indianabutts/picocart/Pinout.ods

Sheet: Sheet1
 | 28 | 27 | 26 | 25 | 24 | 23 | 22 | 21 | 20 | 19 | 18 | 17 | 16 | 15 | 14 | 13 | 12 | 11 | 10 | 9 | 8 | 7 | 6 | 5 | 4 | 3 | 2 | 1 | 0
 | nDOE | nAOE | nWAIT | X | X | X | nWRITE | nSLT | nREAD | X | X | X | X | AD15 | AD14 | AD13 | AD12 | AD11 | AD10 | AD9 | AD8 | AD7 | AD6 | AD5 | AD4 | AD3 | AD2 | AD1 | AD0 | Bin 1 | Bin 2 | Bin 3 | Bin 4 | Full Bin | Hex 1 | Hex 2 | Hex 3 | Hex 4 | Full Hex | C_String
INIT_MASK | 1 | 1 | 1 | 0 | 0 | 0 | 0 | 1 | 1 | 0 | 0 | 0 | 0 | 1 | 1 | 1 | 1 | 1 | 1 | 1 | 1 | 1 | 1 | 1 | 1 | 1 | 1 | 1 | 1 | 00011100 | 00110000 | 11111111 | 11111111 | 00011100001100001111111111111111 | 1C | 30 | FF | FF | 0x1C30FFFF | #define C_GPIO_INIT_MASK 0x1C30FFFF
AD_MASK | 0 | 0 | 0 | 0 | 0 | 0 | 0 | 0 | 0 | 0 | 0 | 0 | 0 | 1 | 1 | 1 | 1 | 1 | 1 | 1 | 1 | 1 | 1 | 1 | 1 | 1 | 1 | 1 | 1 | 00000000 | 00000000 | 11111111 | 11111111 | 00000000000000001111111111111111 | 00 | 00 | FF | FF | 0x0000FFFF | #define C_GPIO_AD_MASK 0x0000FFFF
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
