indianabutts/picocart/boards/footprints/ABM8AIG/ABM8AIG-8.000MHZ-1Z-T--3DModel-STEP-269445.STEP

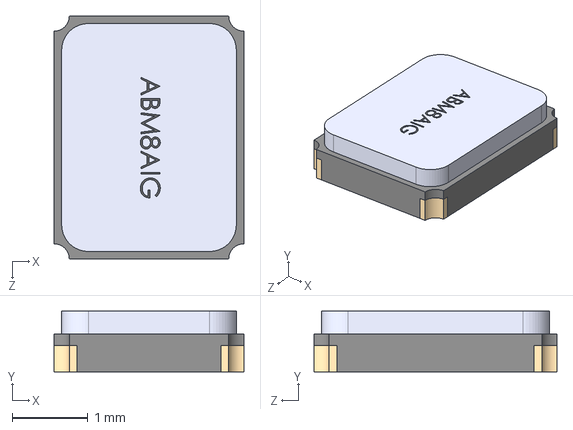
[picture p7: CAD file, 2024-03-03]
boards/footprints/ABM8AIG/ABM8AIG-8.000MHZ-1Z-T--3DModel-STEP-269445.STEP
2.50 x 0.801 x 3.20 mm
