indianabutts/picocart/boards/footprints/DM3AT-SF-PEJM5 Model/DM3AT-SF-PEJM5--3DModel-STEP-1.STEP

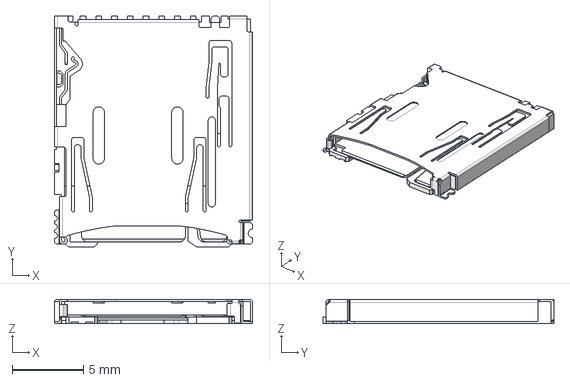
[picture p8: CAD file, 2024-03-03]
boards/footprints/DM3AT-SF-PEJM5 Model/DM3AT-SF-PEJM5--3DModel-STEP-1.STEP
13.8 x 16.2 x 1.68 mm
