indianabutts/picocart/(list of files, cad)

Other CAD files:
boards/full_bus_board/templates/KiCad-RP-Pico-main/SketchUp Model/Pico.skp
