indianabutts/picocart/boards/full_bus_board/rev2b.pdf

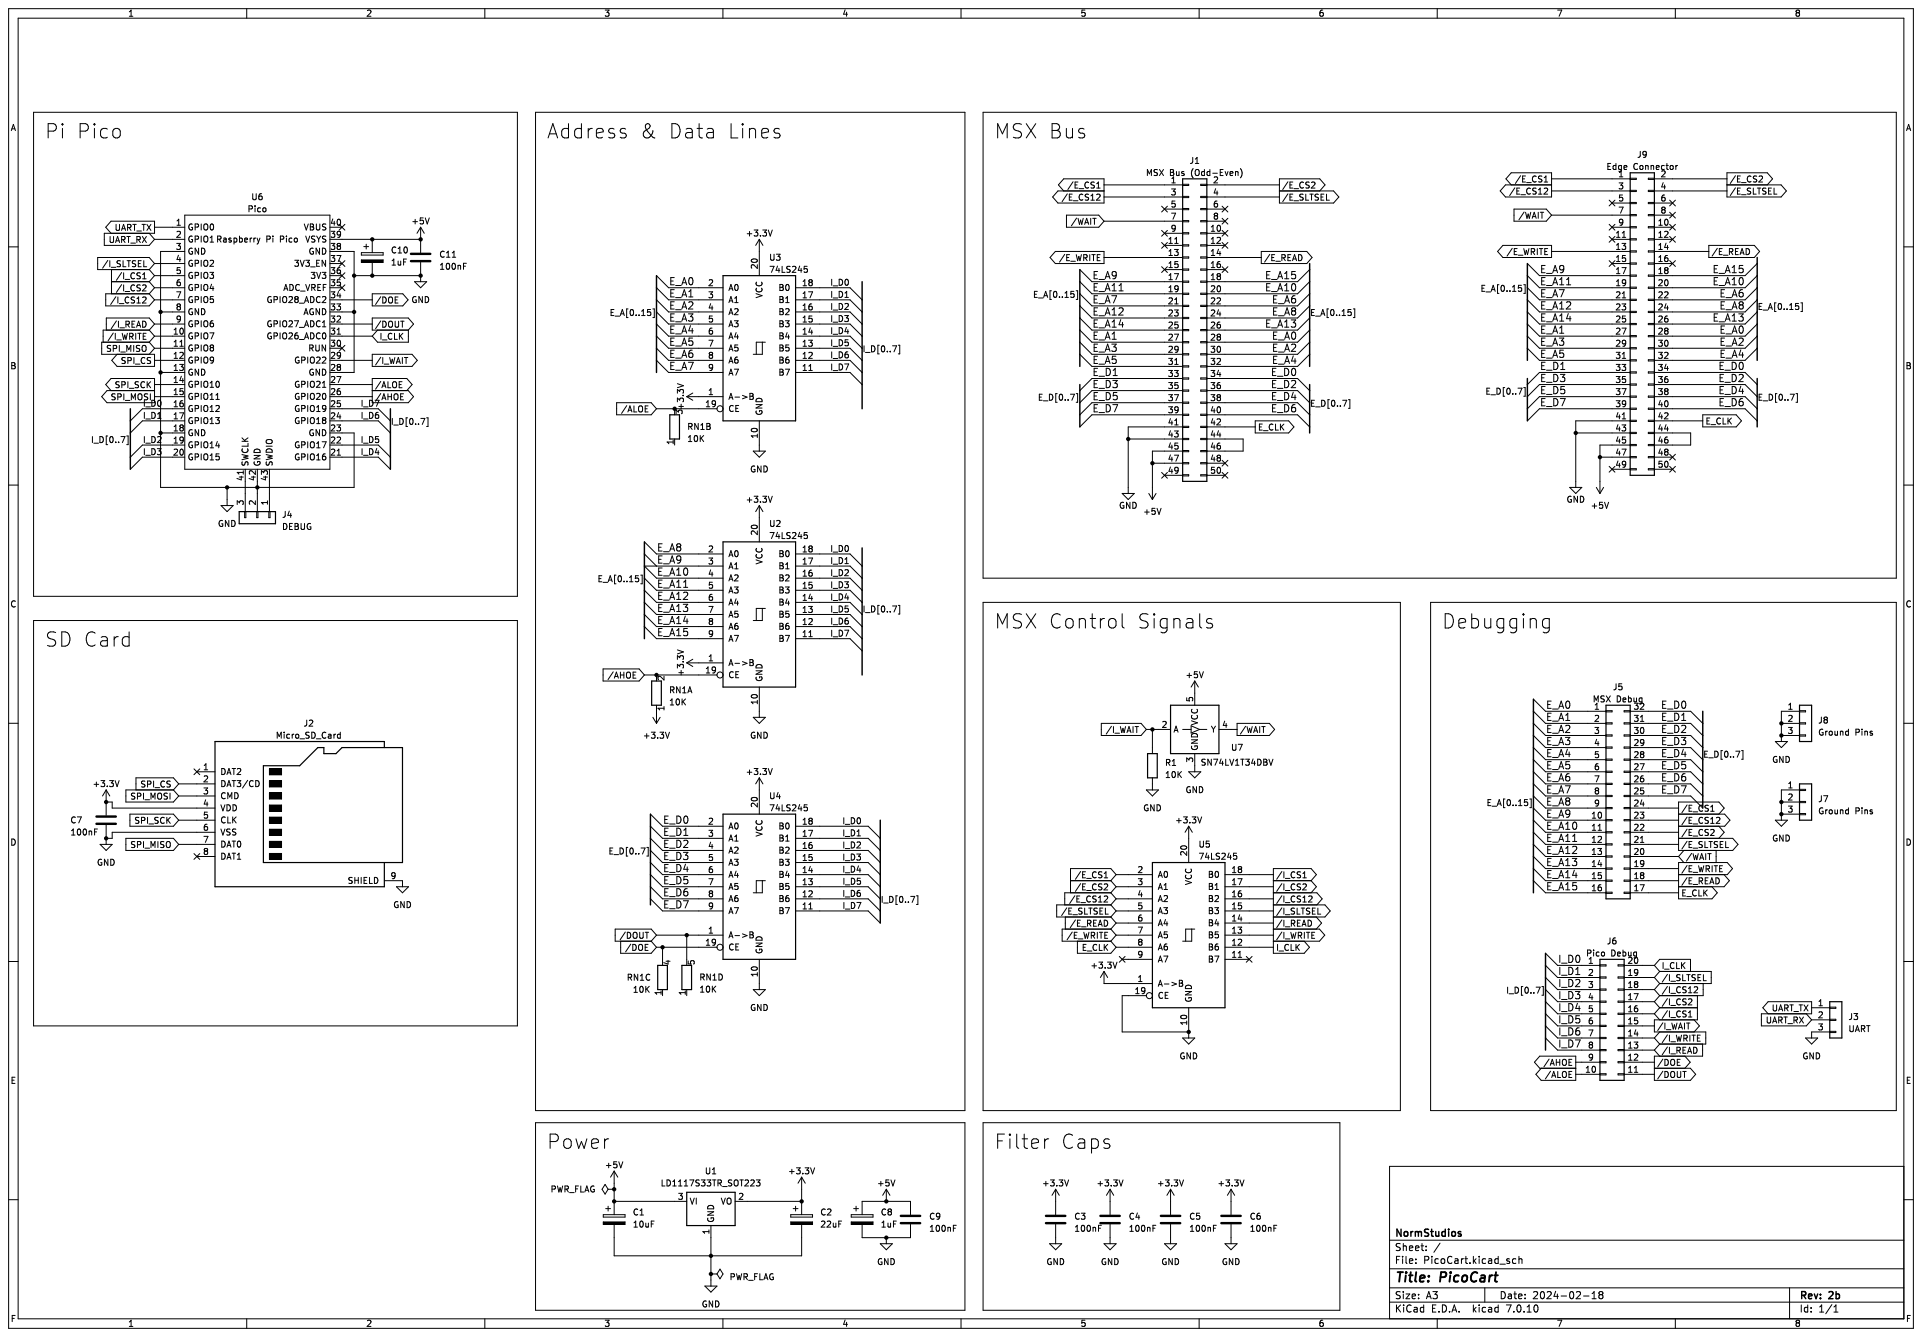
[picture p22: page 1]
