indianabutts/picocart/boards/full_bus_board/PicoCart.kicad_pcb

## KiCad design boards/full_bus_board/PicoCart.kicad_pcb (2024-06-12)

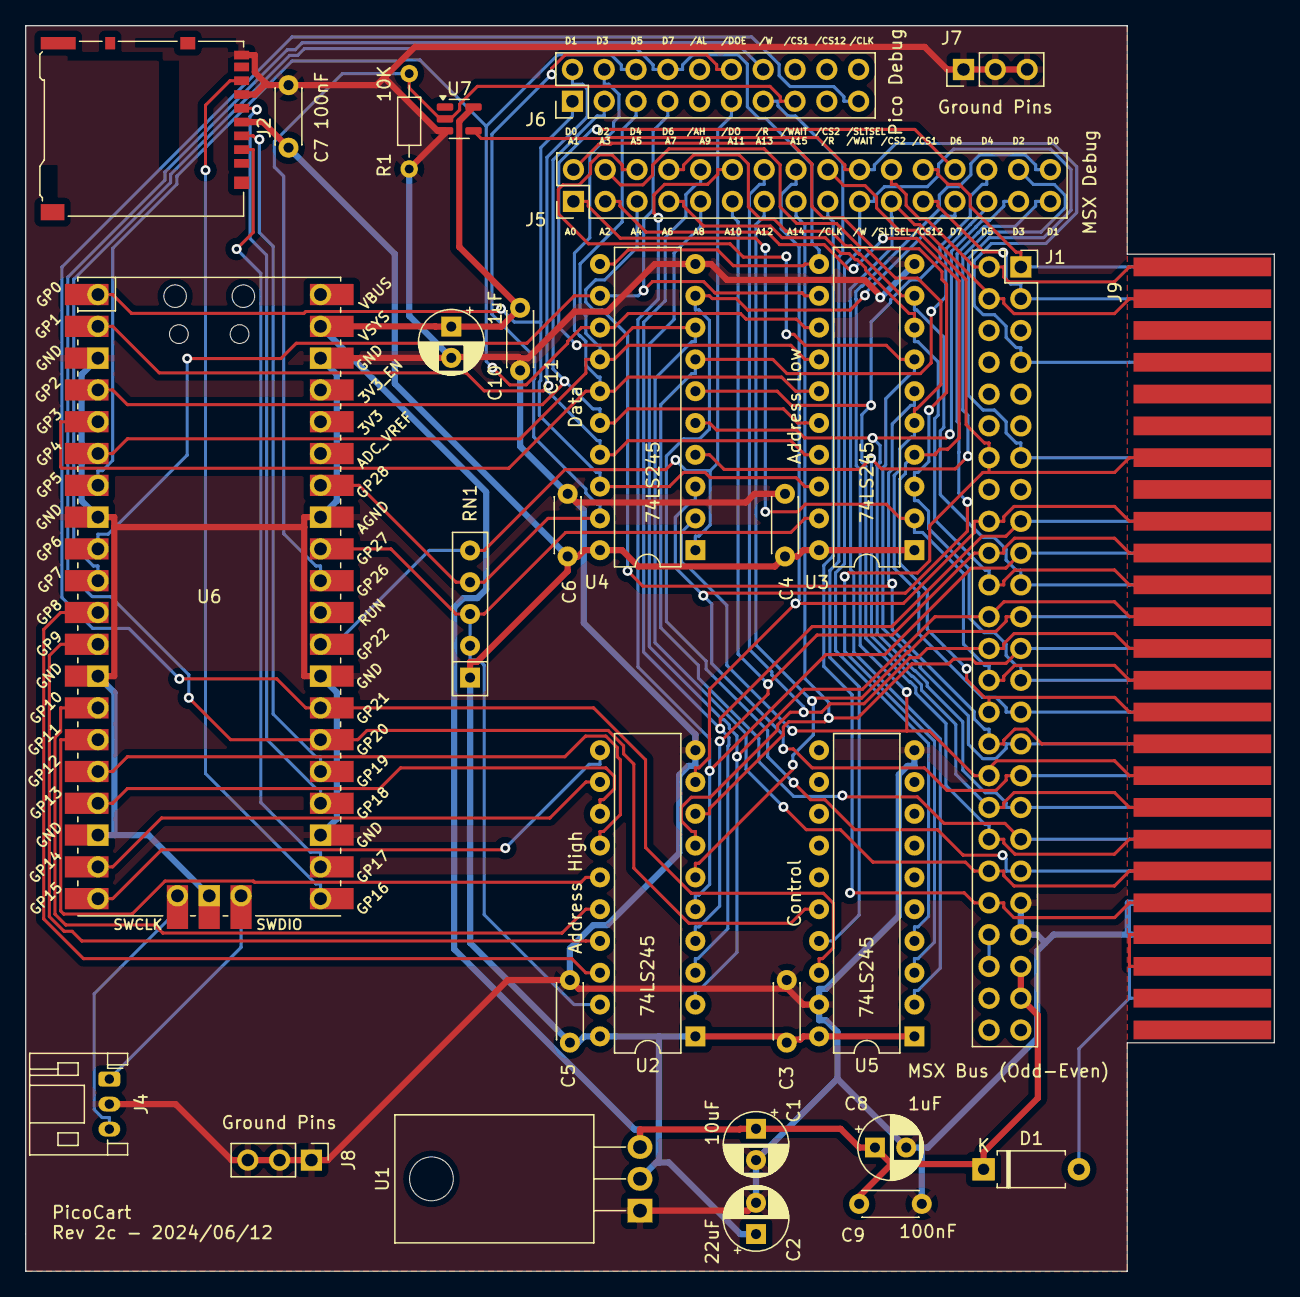
[picture p23: board PicoCart.kicad_pcb from above]

Board: 2 copper layers, 99.8 x 99.5 mm, 29 parts (0 on the bottom side), 67 nets.

Parts:
C1: 10uF; CP_Radial_D5.0mm_P2.50mm
C2: 22uF; CP_Radial_D5.0mm_P2.50mm
C3, C4, C5, C6, C7, C9, C11: 100nF; C_Disc_D4.3mm_W1.9mm_P5.00mm
C8, C10: 1uF; CP_Radial_D5.0mm_P2.50mm
D1: D; D_A-405_P7.62mm_Horizontal
J1: MSX Bus (Odd-Even); PinHeader_2x25_P2.54mm_Vertical
J2: Micro_SD_Card; microSD_HC_Hirose_DM3AT-SF-PEJM5
J4: DEBUG; JST_PH_S3B-PH-K_1x03_P2.00mm_Horizontal
J5: MSX Debug; PinHeader_2x16_P2.54mm_Vertical
J6: Pico Debug; PinHeader_2x10_P2.54mm_Vertical
J7, J8: Ground Pins; PinHeader_1x03_P2.54mm_Vertical
J9: Edge Connector; MSX_Cartridge
R1: 10K; R_Axial_DIN0204_L3.6mm_D1.6mm_P7.62mm_Horizontal
RN1: 10K; R_Array_SIP5
U1: LD1117S33TR_SOT223; TO-220-3_Horizontal_TabDown
U2, U3, U4, U5: 74LS245; DIP-20_W7.62mm
U6: Pico; RPi_Pico_SMD_TH
U7: SN74LV1T34DBV; SOT-23-5

Connections:
+3.3V: C2.1, C3.1, C4.1, C5.1, C6.1, C7.1, J2.4 (VDD), RN1.1 (R1.1), U1.2 (VO), U2.1 (A->B), U2.20 (VCC), U3.1 (A->B), U3.20 (VCC), U4.20 (VCC), U5.1 (A->B), U5.20 (VCC)
+5V: C1.1, C8.1, C9.1, C10.1, C11.1, D1.1 (K), J1.45, J1.47, U1.3 (VI), U6.39 (VSYS), U7.5 (VCC)
/E_A0: J1.28, J5.1, J9.28, U3.2 (A0)
/E_A1: J1.27, J5.2, J9.27, U3.3 (A1)
/E_A2: J1.30, J5.3, J9.30, U3.4 (A2)
/E_A3: J1.29, J5.4, J9.29, U3.5 (A3)
/E_A4: J1.32, J5.5, J9.32, U3.6 (A4)
/E_A5: J1.31, J5.6, J9.31, U3.7 (A5)
/E_A6: J1.22, J5.7, J9.22, U3.8 (A6)
/E_A7: J1.21, J5.8, J9.21, U3.9 (A7)
/E_A8: J1.24, J5.9, J9.24, U2.2 (A0)
/E_A9: J1.17, J5.10, J9.17, U2.3 (A1)
/E_A10: J1.20, J5.11, J9.20, U2.4 (A2)
/E_A11: J1.19, J5.12, J9.19, U2.5 (A3)
/E_A12: J1.23, J5.13, J9.23, U2.6 (A4)
/E_A13: J1.26, J5.14, J9.26, U2.7 (A5)
/E_A14: J1.25, J5.15, J9.25, U2.8 (A6)
/E_A15: J1.18, J5.16, J9.18, U2.9 (A7)
/E_D0: J1.34, J5.32, J9.34, U4.2 (A0)
/E_D1: J1.33, J5.31, J9.33, U4.3 (A1)
/E_D2: J1.36, J5.30, J9.36, U4.4 (A2)
/E_D3: J1.35, J5.29, J9.35, U4.5 (A3)
/E_D4: J1.38, J5.28, J9.38, U4.6 (A4)
/E_D5: J1.37, J5.27, J9.37, U4.7 (A5)
/E_D6: J1.40, J5.26, J9.40, U4.8 (A6)
/E_D7: J1.39, J5.25, J9.39, U4.9 (A7)
/I_D0: J6.1, U3.18 (B0), U4.18 (B0), U6.1 (GPIO0)
/I_D1: J6.2, U3.17 (B1), U4.17 (B1), U6.2 (GPIO1)
/I_D2: J6.3, U3.16 (B2), U4.16 (B2), U6.4 (GPIO2)
/I_D3: J6.4, U3.15 (B3), U4.15 (B3), U6.5 (GPIO3)
/I_D4: J6.5, U3.14 (B4), U4.14 (B4), U6.6 (GPIO4)
/I_D5: J6.6, U3.13 (B5), U4.13 (B5), U6.7 (GPIO5)
/I_D6: J6.7, U3.12 (B6), U4.12 (B6), U6.9 (GPIO6)
/I_D7: J6.8, U3.11 (B7), U4.11 (B7), U6.10 (GPIO7)
/I_D8: U2.18 (B0), U6.11 (GPIO8)
/I_D9: U2.17 (B1), U6.12 (GPIO9)
/I_D10: U2.16 (B2), U6.14 (GPIO10)
/I_D11: U2.15 (B3), U6.15 (GPIO11)
/I_D12: U2.14 (B4), U6.16 (GPIO12)
/I_D13: U2.13 (B5), U6.17 (GPIO13)
/I_D14: U2.12 (B6), U6.19 (GPIO14)
/I_D15: U2.11 (B7), U6.20 (GPIO15)
E_CLK: J1.42, J5.17, J9.42
GND: C1.2, C2.2, C3.2, C4.2, C5.2, C6.2, C7.2, C8.2, C9.2, C10.2, C11.2, J1.41, J1.43, J2.6 (VSS), J2.9 (SHIELD), J4.2, J7.1, J7.2, J7.3, J8.1, J8.2, J8.3, J9.41, J9.43, R1.1, U1.1 (GND), U2.10 (GND), U3.10 (GND), U4.10 (GND), U5.10 (GND), U5.19 (CE), U6.3 (GND), U6.8 (GND), U6.13 (GND), U6.18 (GND), U6.23 (GND), U6.28 (GND), U6.33 (AGND), U6.38 (GND), U6.42 (GND), U7.3 (GND)
unnamed: D1.2 (A), J9.45, J9.47
unnamed: J1.44, J1.46
unnamed: J4.1, U6.43 (SWDIO)
unnamed: J4.3, U6.41 (SWCLK)
unnamed: J9.44, J9.46
SPI_CS: J2.2 (DAT3/CD), U6.22 (GPIO17)
SPI_MISO: J2.7 (DAT0), U6.21 (GPIO16)
SPI_MOSI: J2.3 (CMD), U6.25 (GPIO19)
SPI_SCK: J2.5 (CLK), U6.24 (GPIO18)
/AOE: RN1.2 (R1.2), RN1.3 (R2.2), U2.19 (CE), U3.19 (CE), U6.32 (GPIO27_ADC1)
/DOE: J6.12, RN1.4 (R3.2), U4.19 (CE), U6.34 (GPIO28_ADC2)
/DOUT: J6.11, RN1.5 (R4.2), U4.1 (A->B), U6.29 (GPIO22)
/E_CS1: J1.1, J5.24, J9.1
/E_CS2: J1.2, J5.22, J9.2
/E_CS12: J1.3, J5.23, J9.3
/E_READ: J1.14, J5.18, J9.14, U5.3 (A1)
/E_SLTSEL: J1.4, J5.21, J9.4, U5.2 (A0)
/E_WRITE: J1.13, J5.19, J9.13, U5.4 (A2)
/I_READ: J6.13, U5.17 (B1)
/I_SLTSEL: J6.19, U5.18 (B0), U6.27 (GPIO21)
/I_WAIT: J6.15, R1.2, U6.31 (GPIO26_ADC0), U7.2 (A)
/I_WRITE: J6.14, U5.16 (B2), U6.26 (GPIO20)
/WAIT: J1.7, J5.20, J9.7, U7.4 (Y)
