indianabutts/picocart/boards/debug_board/PicoCart_DEBUG.kicad_pcb

## KiCad design boards/debug_board/PicoCart_DEBUG.kicad_pcb (2024-03-08)

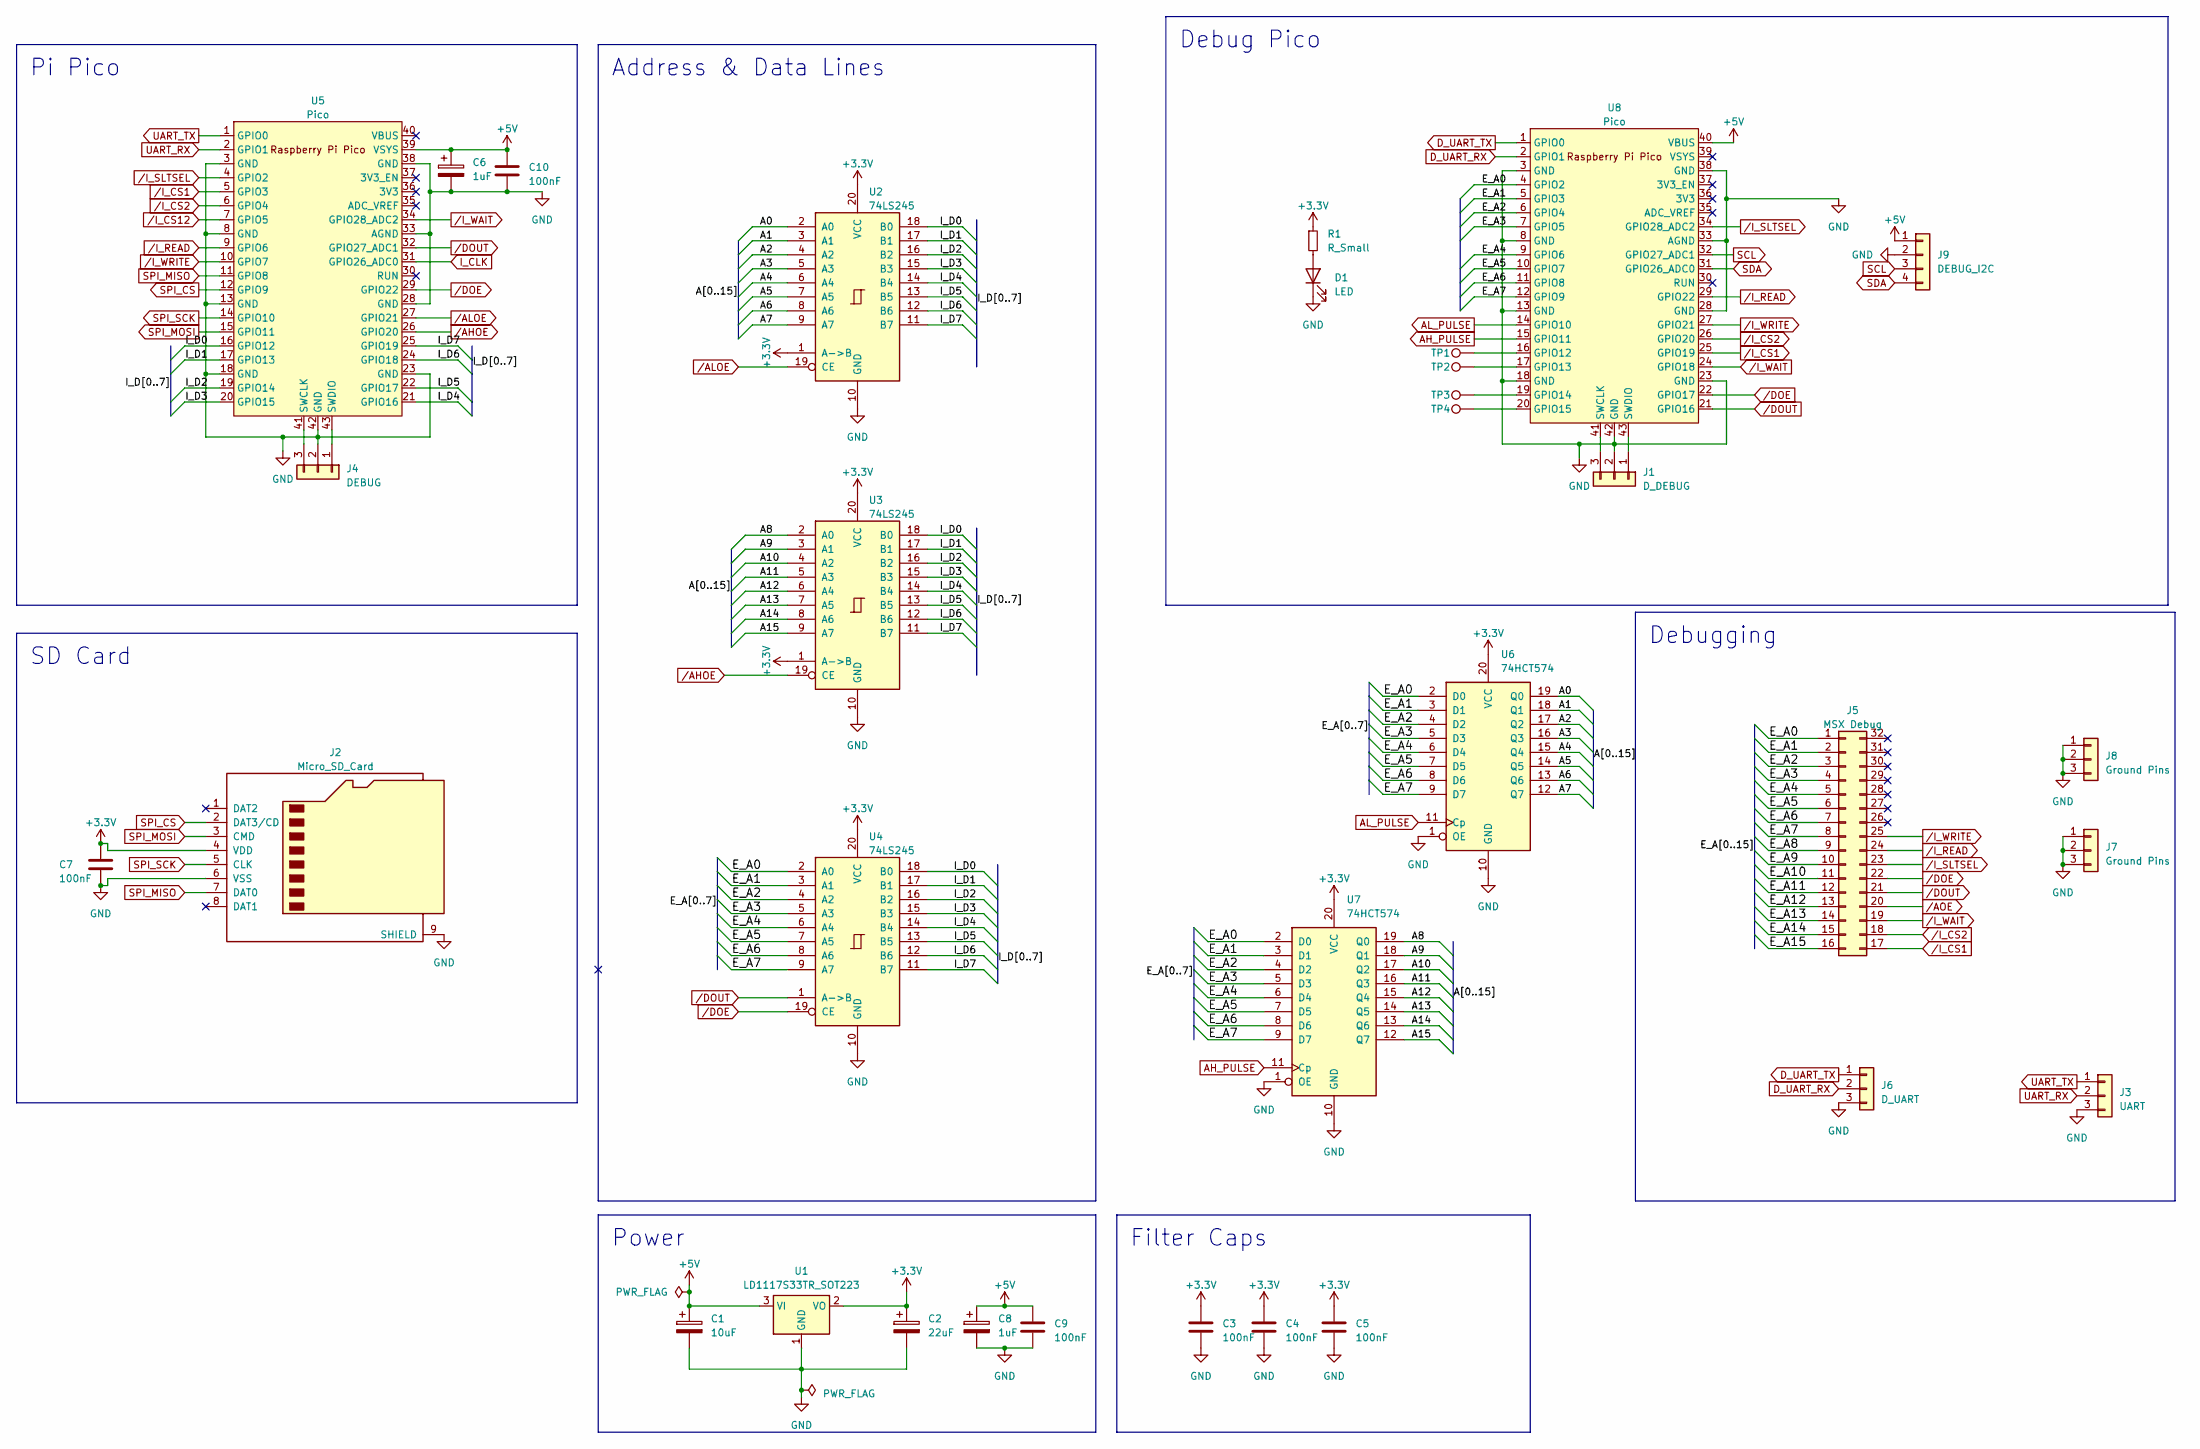
[picture p24: schematic PicoCart_DEBUG.kicad_sch, PicoCart]

Parts:
C1: 10uF; CP_Radial_D5.0mm_P2.50mm
C2: 22uF; CP_Radial_D5.0mm_P2.50mm
C3, C4, C5, C7, C9, C10: 100nF; C_Disc_D4.3mm_W1.9mm_P5.00mm
C6, C8: 1uF; CP_Radial_D5.0mm_P2.50mm
D1: LED; LED_D5.0mm
J1: D_DEBUG; PinSocket_1x03_P2.54mm_Vertical
J2: Micro_SD_Card; microSD_HC_Hirose_DM3AT-SF-PEJM5
J3: UART; PinSocket_1x03_P2.54mm_Vertical
J4: DEBUG; PinSocket_1x03_P2.54mm_Vertical
J5: MSX Debug; PinHeader_2x16_P2.54mm_Vertical
J6: D_UART; PinSocket_1x03_P2.54mm_Vertical
J7, J8: Ground Pins; PinHeader_1x03_P2.54mm_Vertical
J9: DEBUG_I2C; PinHeader_1x04_P2.54mm_Vertical
R1: R_Small; R_Axial_DIN0207_L6.3mm_D2.5mm_P15.24mm_Horizontal
TP1, TP2, TP3, TP4: TestPoint; TestPoint_Pad_D1.0mm
U1: LD1117S33TR_SOT223; TO-220-3_Horizontal_TabDown
U2, U3, U4: 74LS245; DIP-20_W7.62mm
U5, U8: Pico; RPi_Pico_SMD_TH
U6, U7: 74HCT574; DIP-20_W7.62mm_Socket_LongPads

Connections:
+3.3V: C2.1, C3.1, C4.1, C5.1, C7.1, J2.4 (VDD), R1.1, U1.2 (VO), U2.1 (A->B), U2.20 (VCC), U3.1 (A->B), U3.20 (VCC), U4.20 (VCC), U6.20 (VCC), U7.20 (VCC)
+5V: C1.1, C6.1, C8.1, C9.1, C10.1, J9.1, U1.3 (VI), U5.39 (VSYS), U8.40 (VBUS)
/A0: U2.2 (A0), U6.19 (Q0)
/A1: U2.3 (A1), U6.18 (Q1)
/A2: U2.4 (A2), U6.17 (Q2)
/A3: U2.5 (A3), U6.16 (Q3)
/A4: U2.6 (A4), U6.15 (Q4)
/A5: U2.7 (A5), U6.14 (Q5)
/A6: U2.8 (A6), U6.13 (Q6)
/A7: U2.9 (A7), U6.12 (Q7)
/A8: U3.2 (A0), U7.19 (Q0)
/A9: U3.3 (A1), U7.18 (Q1)
/A10: U3.4 (A2), U7.17 (Q2)
/A11: U3.5 (A3), U7.16 (Q3)
/A12: U3.6 (A4), U7.15 (Q4)
/A13: U3.7 (A5), U7.14 (Q5)
/A14: U3.8 (A6), U7.13 (Q6)
/A15: U3.9 (A7), U7.12 (Q7)
/E_A0: J5.1, U4.2 (A0), U6.2 (D0), U7.2 (D0), U8.4 (GPIO2)
/E_A1: J5.2, U4.3 (A1), U6.3 (D1), U7.3 (D1), U8.5 (GPIO3)
/E_A2: J5.3, U4.4 (A2), U6.4 (D2), U7.4 (D2), U8.6 (GPIO4)
/E_A3: J5.4, U4.5 (A3), U6.5 (D3), U7.5 (D3), U8.7 (GPIO5)
/E_A4: J5.5, U4.6 (A4), U6.6 (D4), U7.6 (D4), U8.9 (GPIO6)
/E_A5: J5.6, U4.7 (A5), U6.7 (D5), U7.7 (D5), U8.10 (GPIO7)
/E_A6: J5.7, U4.8 (A6), U6.8 (D6), U7.8 (D6), U8.11 (GPIO8)
/E_A7: J5.8, U4.9 (A7), U6.9 (D7), U7.9 (D7), U8.12 (GPIO9)
/E_A8: J5.9
/E_A9: J5.10
/E_A10: J5.11
/E_A11: J5.12
/E_A12: J5.13
/E_A13: J5.14
/E_A14: J5.15
/E_A15: J5.16
/I_D0: U2.18 (B0), U3.18 (B0), U4.18 (B0), U5.16 (GPIO12)
/I_D1: U2.17 (B1), U3.17 (B1), U4.17 (B1), U5.17 (GPIO13)
/I_D2: U2.16 (B2), U3.16 (B2), U4.16 (B2), U5.19 (GPIO14)
/I_D3: U2.15 (B3), U3.15 (B3), U4.15 (B3), U5.20 (GPIO15)
/I_D4: U2.14 (B4), U3.14 (B4), U4.14 (B4), U5.21 (GPIO16)
/I_D5: U2.13 (B5), U3.13 (B5), U4.13 (B5), U5.22 (GPIO17)
/I_D6: U2.12 (B6), U3.12 (B6), U4.12 (B6), U5.24 (GPIO18)
/I_D7: U2.11 (B7), U3.11 (B7), U4.11 (B7), U5.25 (GPIO19)
AH_PULSE: U7.11 (Cp), U8.15 (GPIO11)
AL_PULSE: U6.11 (Cp), U8.14 (GPIO10)
D_UART_RX: J6.2, U8.2 (GPIO1)
D_UART_TX: J6.1, U8.1 (GPIO0)
GND: C1.2, C2.2, C3.2, C4.2, C5.2, C6.2, C7.2, C8.2, C9.2, C10.2, D1.1 (K), J1.2, J2.6 (VSS), J2.9 (SHIELD), J3.3, J4.2, J6.3, J7.1, J7.2, J7.3, J8.1, J8.2, J8.3, J9.2, U1.1 (GND), U2.10 (GND), U3.10 (GND), U4.10 (GND), U5.3 (GND), U5.8 (GND), U5.13 (GND), U5.18 (GND), U5.23 (GND), U5.28 (GND), U5.33 (AGND), U5.38 (GND), U5.42 (GND), U6.1 (OE), U6.10 (GND), U7.1 (OE), U7.10 (GND), U8.3 (GND), U8.8 (GND), U8.13 (GND), U8.18 (GND), U8.23 (GND), U8.28 (GND), U8.33 (AGND), U8.38 (GND), U8.42 (GND)
I_CLK: U5.31 (GPIO26_ADC0)
unnamed: D1.2 (A), R1.2
unnamed: J1.1, U8.43 (SWDIO)
unnamed: J1.3, U8.41 (SWCLK)
unnamed: J4.1, U5.43 (SWDIO)
unnamed: J4.3, U5.41 (SWCLK)
unnamed: TP1.1, U8.16 (GPIO12)
unnamed: TP2.1, U8.17 (GPIO13)
unnamed: TP3.1, U8.19 (GPIO14)
unnamed: TP4.1, U8.20 (GPIO15)
SCL: J9.3, U8.32 (GPIO27_ADC1)
SDA: J9.4, U8.31 (GPIO26_ADC0)
SPI_CS: J2.2 (DAT3/CD), U5.12 (GPIO9)
SPI_MISO: J2.7 (DAT0), U5.11 (GPIO8)
SPI_MOSI: J2.3 (CMD), U5.15 (GPIO11)
SPI_SCK: J2.5 (CLK), U5.14 (GPIO10)
UART_RX: J3.2, U5.2 (GPIO1)
UART_TX: J3.1, U5.1 (GPIO0)
/AHOE: U3.19 (CE), U5.26 (GPIO20)
/ALOE: U2.19 (CE), U5.27 (GPIO21)
/AOE: J5.20
/DOE: J5.22, U4.19 (CE), U5.29 (GPIO22), U8.22 (GPIO17)
/DOUT: J5.21, U4.1 (A->B), U5.32 (GPIO27_ADC1), U8.21 (GPIO16)
/I_CS1: J5.17, U5.5 (GPIO3), U8.25 (GPIO19)
/I_CS2: J5.18, U5.6 (GPIO4), U8.26 (GPIO20)
/I_CS12: U5.7 (GPIO5)
/I_READ: J5.24, U5.9 (GPIO6), U8.29 (GPIO22)
/I_SLTSEL: J5.23, U5.4 (GPIO2), U8.34 (GPIO28_ADC2)
/I_WAIT: J5.19, U5.34 (GPIO28_ADC2), U8.24 (GPIO18)
/I_WRITE: J5.25, U5.10 (GPIO7), U8.27 (GPIO21)

Notes on the sheet:
Pi Pico
Debug Pico
Debugging
Filter Caps
Power
SD Card
Address & Data Lines

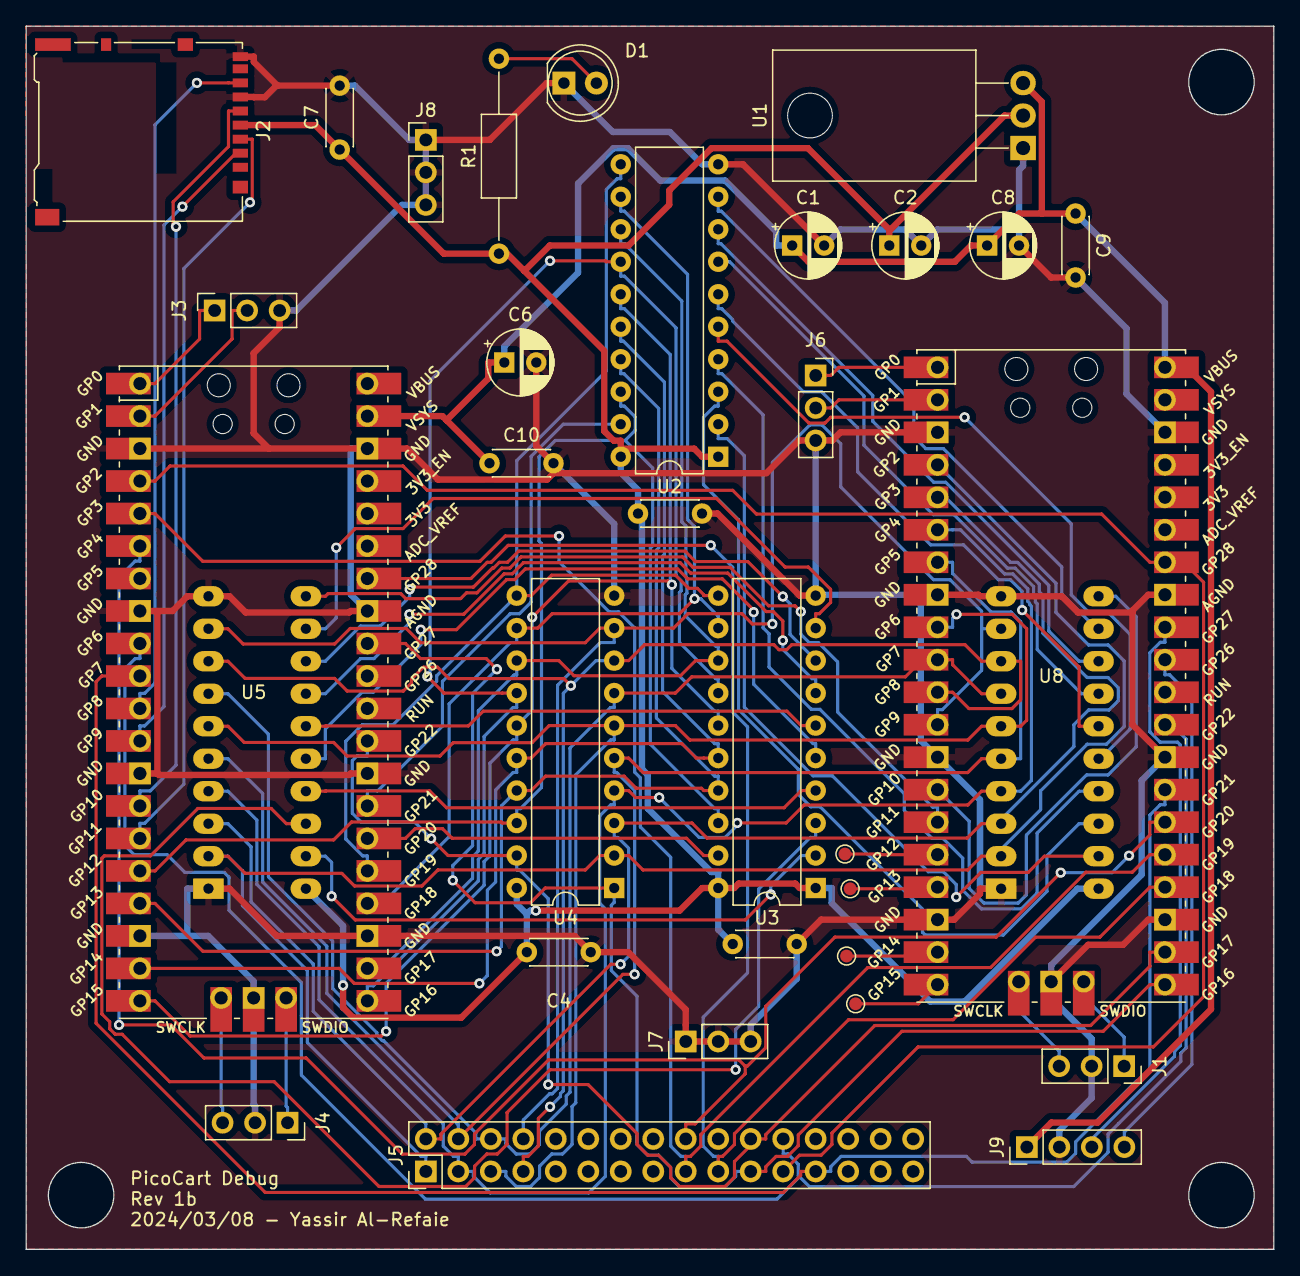
[picture p25: board PicoCart_DEBUG.kicad_pcb from above]

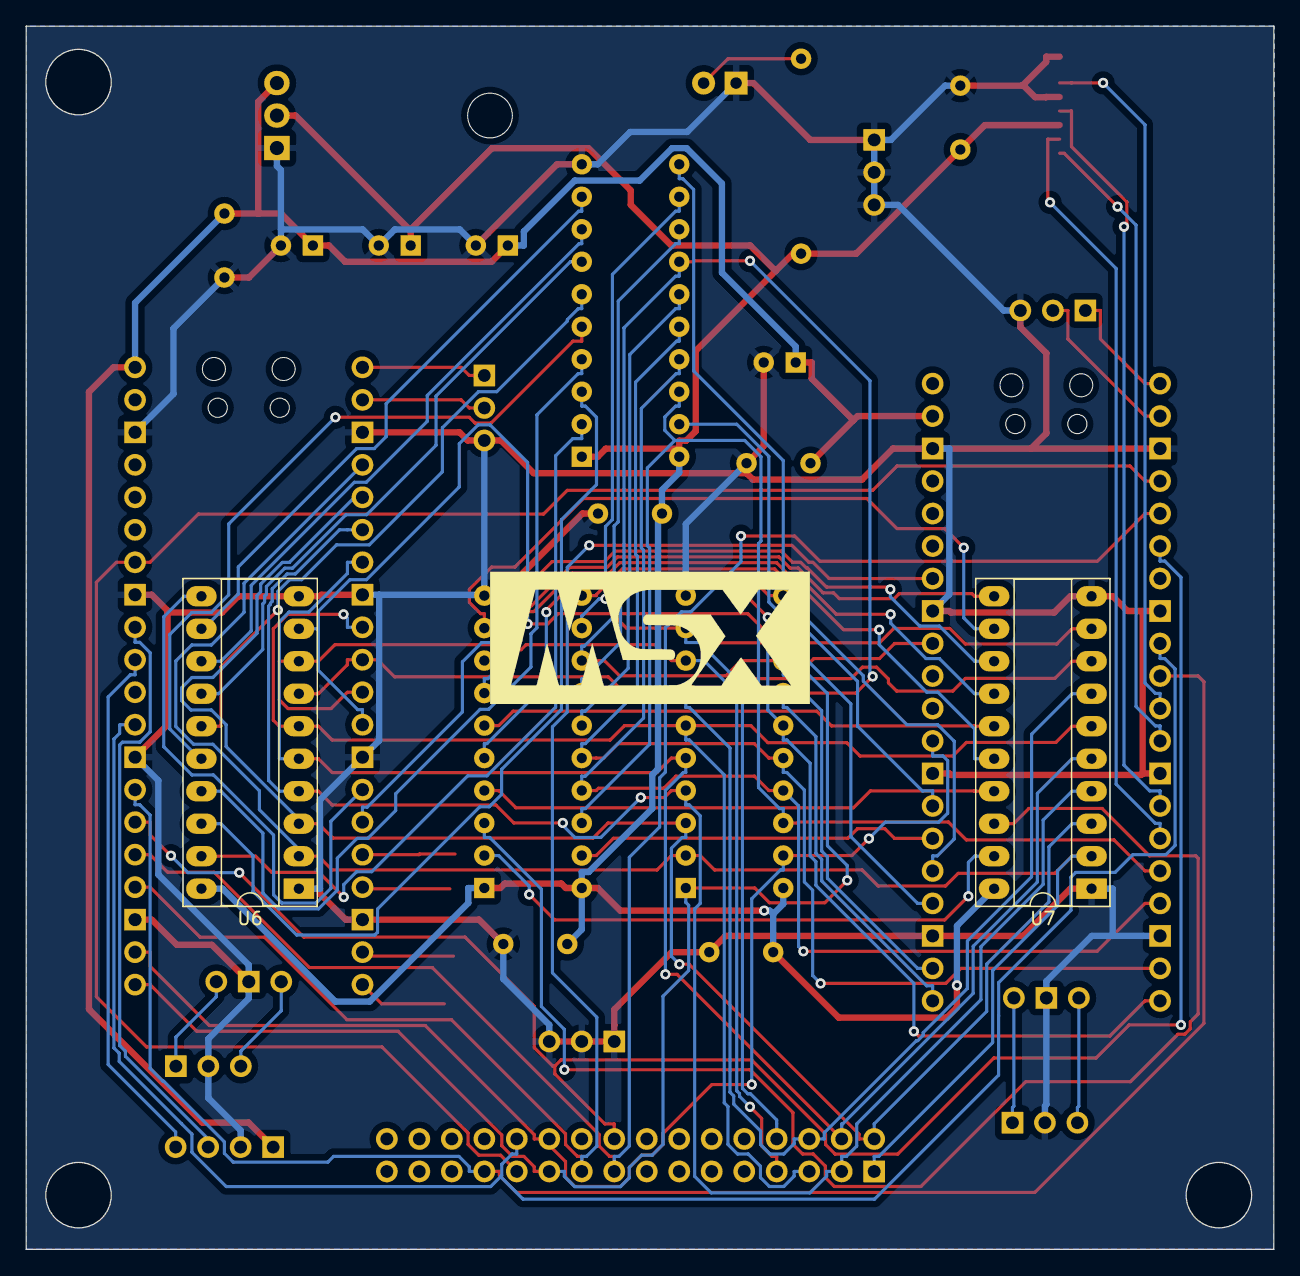
[picture p26: board PicoCart_DEBUG.kicad_pcb from below]

Board: 2 copper layers, 97.5 x 95.6 mm, 33 parts (2 on the bottom side), 66 nets.
