indianabutts/picocart/rp2040_src/core_board/shared_includes/data.h

#ifndef DEBUG_MSX_DATA_H
#define DEBUG_MSX_DATA_H

// array size is 8192
static const unsigned char debug_data[]  = {
  0x41, 0x42, 0x20, 0x40, 0x00, 0x00, 0x00, 0x00, 0x00, 0x00, 0x00, 0x00, 0x00, 0x00, 0x00, 0x00, 
  0x06, 0x20, 0x54, 0x61, 0x6e, 0x6b, 0x20, 0x42, 0x61, 0x74, 0x61, 0x6c, 0x69, 0x6f, 0x6e, 0x20, 
  0x31, 0x00, 0xff, 0x21, 0x00, 0xe0, 0x36, 0x00, 0x23, 0x7c, 0xfe, 0xee, 0x20, 0xf8, 0x21, 0xfc, 
  0x40, 0x01, 0x00, 0x08, 0xc5, 0x46, 0xcd, 0x47, 0x00, 0xc1, 0x23, 0x0c, 0x10, 0xf6, 0xcd, 0xc4, 
  0x40, 0xcd, 0x4f, 0x52, 0x11, 0x40, 0xe8, 0x01, 0x10, 0x41, 0xcd, 0xcf, 0x40, 0x11, 0x80, 0xe8, 
  0x01, 0xa6, 0x58, 0xcd, 0xcf, 0x40, 0x3e, 0x07, 0x1e, 0xb8, 0xcd, 0x93, 0x00, 0x3e, 0xc3, 0x32, 
  0x9a, 0xfd, 0x21, 0x70, 0x40, 0x22, 0x9b, 0xfd, 0x01, 0x01, 0xe2, 0xcd, 0x47, 0x00, 0x18, 0xfe, 
  0x31, 0x00, 0xff, 0xcd, 0x3e, 0x01, 0x01, 0x01, 0xc2, 0xcd, 0x47, 0x00, 0x11, 0x80, 0xe8, 0xcd, 
  0xde, 0x40, 0xcd, 0x44, 0x56, 0x3a, 0x10, 0xe0, 0x0f, 0x30, 0x0b, 0x3a, 0x97, 0xe0, 0xa7, 0x28, 
  0xd7, 0xcd, 0x52, 0x43, 0x18, 0xd2, 0x21, 0x00, 0xef, 0x11, 0x00, 0x2f, 0x01, 0xa0, 0x00, 0xcd, 
  0x5c, 0x00, 0xcd, 0xc4, 0x40, 0x21, 0x48, 0xe0, 0x36, 0x20, 0x3a, 0x16, 0xe0, 0x0f, 0x38, 0x05, 
  0x21, 0x7c, 0xef, 0x18, 0x03, 0x21, 0x00, 0xef, 0x22, 0x49, 0xe0, 0x11, 0x40, 0xe8, 0xcd, 0xde, 
  0x40, 0xc3, 0x68, 0x40, 0x01, 0xe0, 0x80, 0x21, 0x00, 0xef, 0x71, 0x23, 0x10, 0xfc, 0xc9, 0x21, 
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
  0xe0, 0x35, 0x3a, 0x61, 0xe0, 0xd6, 0x01, 0x27, 0x32, 0x61, 0xe0, 0xcd, 0x17, 0x58, 0xc3, 0x10, 
  0x43, 0x3a, 0x19, 0xe0, 0xa7, 0xca, 0xf8, 0x42, 0x3a, 0x61, 0xe0, 0xd6, 0x01, 0x27, 0x32, 0x61, 
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
};

#endif
