indianabutts/picocart/rp2040_src/core_board/shared_includes/sd_hw.c

#include <assert.h>
#include <string.h>
#include "hw_config.h"
#include "diskio.h" /* Declarations of disk functions */

// SPI Defines
// We are going to use SPI 0, and allocate it to the following GPIO pins
// Pins can be changed, see the GPIO function select table in the datasheet for information on GPIO assignments
#define SPI_PORT spi1
#define PIN_MISO 16
#define PIN_CS   17
#define PIN_SCK  18
#define PIN_MOSI 19

static spi_t spis[] = {
    {
	.hw_inst = spi1,
	.miso_gpio = PIN_MISO,
	.mosi_gpio = PIN_MOSI,
	.sck_gpio = PIN_SCK,
	.baud_rate = 12500 * 1000
    }
};

static sd_card_t sd_cards[] = {
    {
	.pcName = "0:",
	.spi = &spis[0],
	.ss_gpio = PIN_CS,
	.use_card_detect = false
    }
};

size_t sd_get_num() { return count_of(sd_cards);}

sd_card_t *sd_get_by_num(size_t num) {
    assert(num <= sd_get_num());
    if (num <= sd_get_num()){
	return &sd_cards[num];
    } else {
	return NULL;
    }
}

size_t spi_get_num() { return count_of(spis); }
spi_t *spi_get_by_num(size_t num) {
    assert(num <= spi_get_num());
    if (num <= spi_get_num()) {
        return &spis[num];
    } else {
        return NULL;
    }
}
