indianabutts/picocart/(commit log)

2023-10-09 Add SD library for Pi Pico
2024-02-17 brought board and rp2040 src together
    [Pico.skp, PicoCart.kicad_pcb, PicoCart.kicad_sch, Test.kicad_pcb, Test.kicad_sch]
2024-02-18 Tidied up Schematic
    [PicoCart.kicad_sch]
2024-02-18 Swapped DoE and IWait
    [PicoCart.kicad_sch]
2024-03-03 Debug Board Design
    Created a Debug board so that I can test the Main Pico logic against a
    more controllable set of signals, rather than the MSX which provides a
    very short window of usability
    [ABM8AIG-8.000MHZ-1Z-T--3DModel-STEP-269445.STEP, DM3AT-SF-PEJM5--3DModel-STEP-1.STEP, PicoCart.kicad_pcb, PicoCart.kicad_sch]
2024-03-03 Separate Debug and Main Board Projects
    [ABM8AIG-8.000MHZ-1Z-T--3DModel-STEP-269445.STEP, DM3AT-SF-PEJM5--3DModel-STEP-1.STEP, Pico.skp, PicoCart.kicad_pcb, PicoCart.kicad_sch, PicoCart_DEBUG.kicad_pcb, PicoCart_DEBUG.kicad_sch, Test.kicad_pcb]
2024-03-08 Fixed circuit - last design would not have worked
    [PicoCart_DEBUG.kicad_pcb, PicoCart_DEBUG.kicad_sch]
2024-03-08 Add Test Points for Spare GPIO Pins
    [PicoCart_DEBUG.kicad_pcb, PicoCart_DEBUG.kicad_sch]
2024-03-23 Add Debug Board Src dir
2024-03-24 Initial Printing to LCD Display
2024-03-26 Display Works and Debug board triggers main board
    Not full functionality by any means, but the debug board now pulses
    nSLTSEL, which triggers an IRQ Event on the main board
    This then triggers the IRQ on the Debug board by pulsing the wait
    signal.
2024-03-27 Added Data for Debug Board
2024-03-27 Commiting current state of Core before full rewrite
2024-03-29 Started Core Logic, handshaking not working here
    [core.c, debug_board.c, debug_gpio.c, debug_gpio.h, gpio.c, gpio.h]
2024-03-31 Debug Board Read Data Confirmed working
2024-03-31 Handshaking works between the two boards now
2024-04-06 Writing Address Confirmed on Debug Board
2024-06-12 Added 16 data lines
    [PicoCart.kicad_pcb, PicoCart.kicad_sch]
2024-08-09 committing code from debug board will make into 16 bit version
2024-12-11 Change GPIO Pinout for 16-bit version
    [PicoCart.kicad_sch]
2024-12-13 Got it booting without interfering using individual
    [core.c, gpio.c, gpio.h]
2024-12-13 Seems to have an affect, which means its writing
    i think it's missing some addresses though
    [core.c, gpio.c]
2024-12-17 Started PIO
    [Pico.skp, PicoCart.kicad_pcb, PicoCart.kicad_sch, Pinout.ods, Test.kicad_pcb, Test.kicad_sch]
